WiktorPWR/Robot-Arm-2/Code/Rasberry-Pi-code/Readme.md

Here you will find a description of how the code works and what role the Raspberry Pi plays in the entire project.
