WiktorPWR/Robot-Arm-2/Code/STM32-code/Readme.md

Here you will find a description of how the code works and what function the STM32 itself performs in the entire project.
