WiktorPWR/Robot-Arm-2/images/communication_seuensce_diagram.png

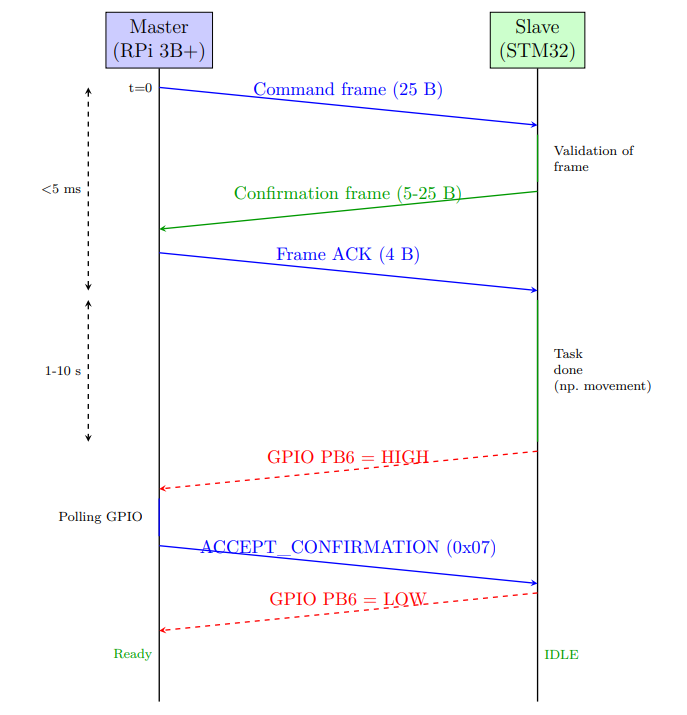
images/communication_seuensce_diagram.png
