WiktorPWR/Robot-Arm-2/images/communication_state_machine.png

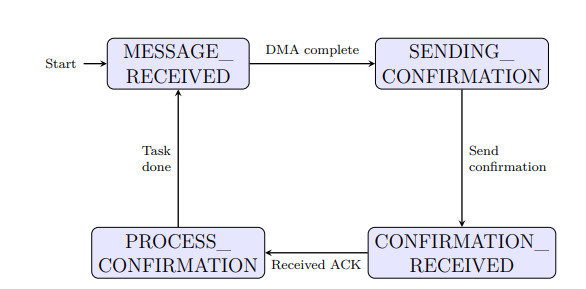
images/communication_state_machine.png
