WiktorPWR/Robot-Arm-2/images/Komunikacja_nkoder_magnetyczny.drawio.png

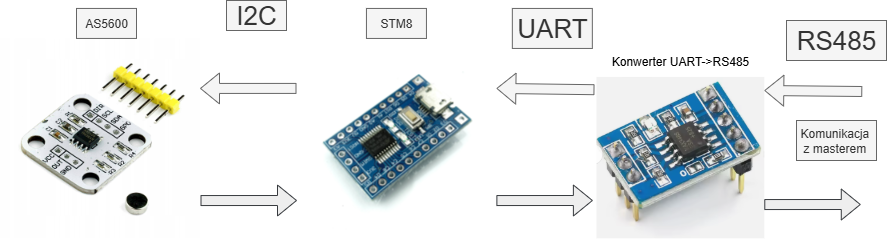
images/Komunikacja_nkoder_magnetyczny.drawio.png
