WiktorPWR/Robot-Arm-2/images/machine_state_rs485.png

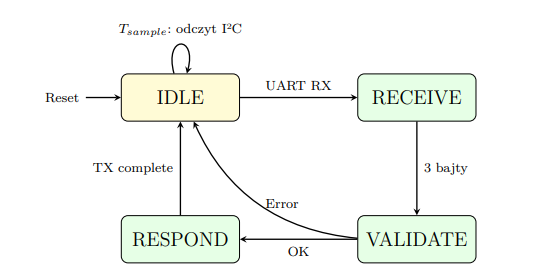
images/machine_state_rs485.png
