WiktorPWR/Robot-Arm-2/images/overengier_meme.jpg

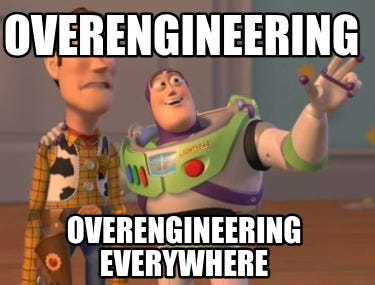
images/overengier_meme.jpg
