WiktorPWR/Robot-Arm-2/images/Oś_1_przekładania_zdjecie.jpg

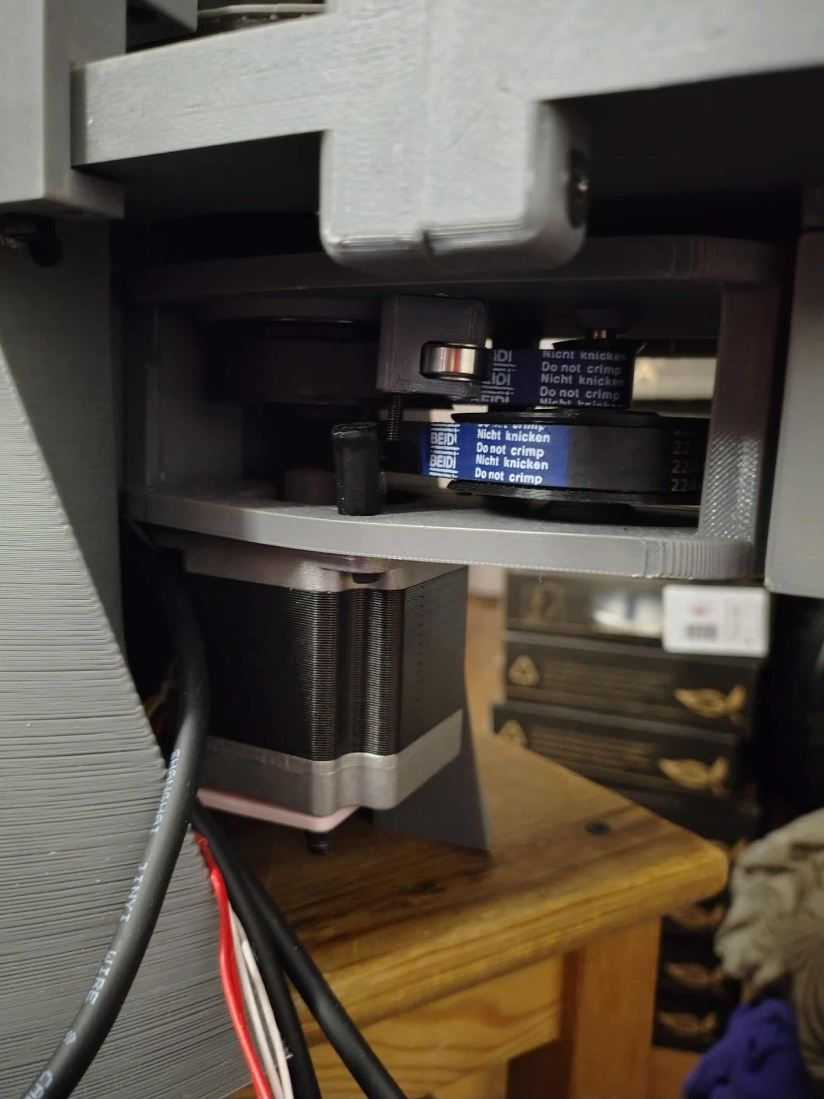
images/Oś_1_przekładania_zdjecie.jpg
