WiktorPWR/Robot-Arm-2/images/Oś_2_3_przekładania_zdjecie.jpg

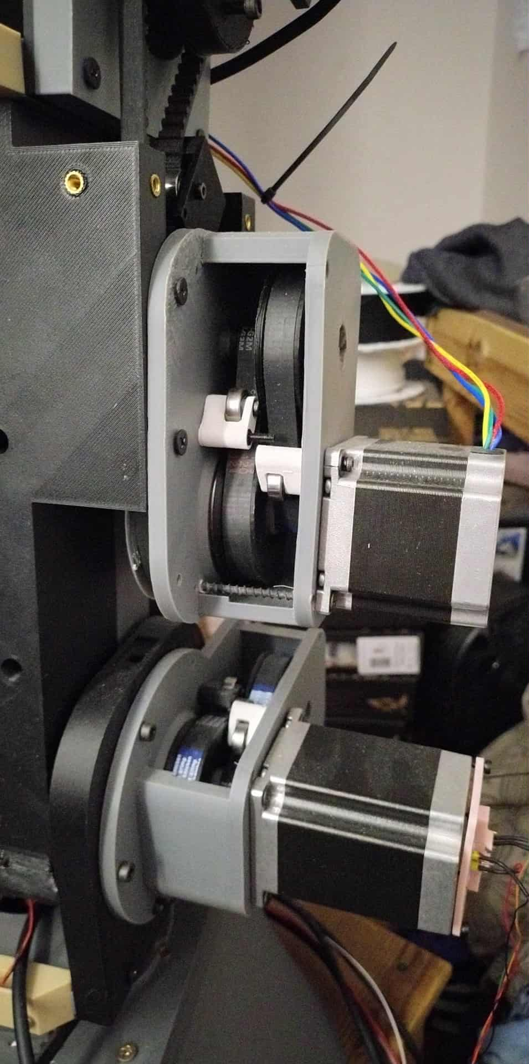
images/Oś_2_3_przekładania_zdjecie.jpg
