WiktorPWR/Robot-Arm-2/images/Oś_5_przekładania_zdjecie.jpg

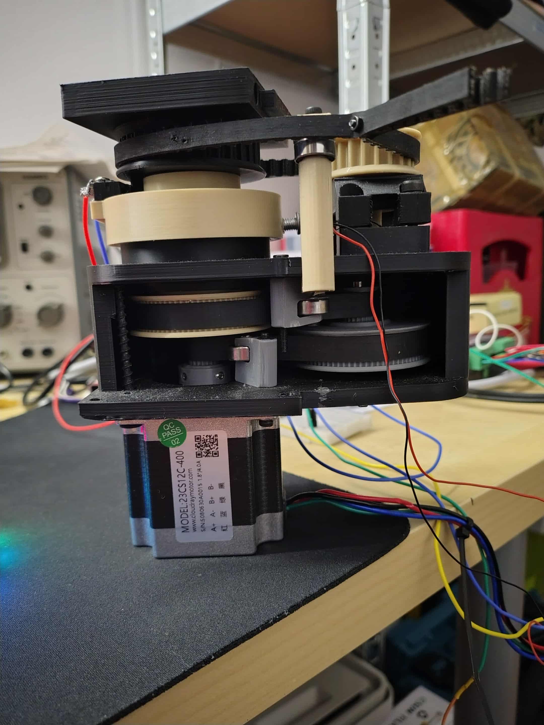
images/Oś_5_przekładania_zdjecie.jpg
