WiktorPWR/Robot-Arm-2/images/rs485_sequence_diagram.png

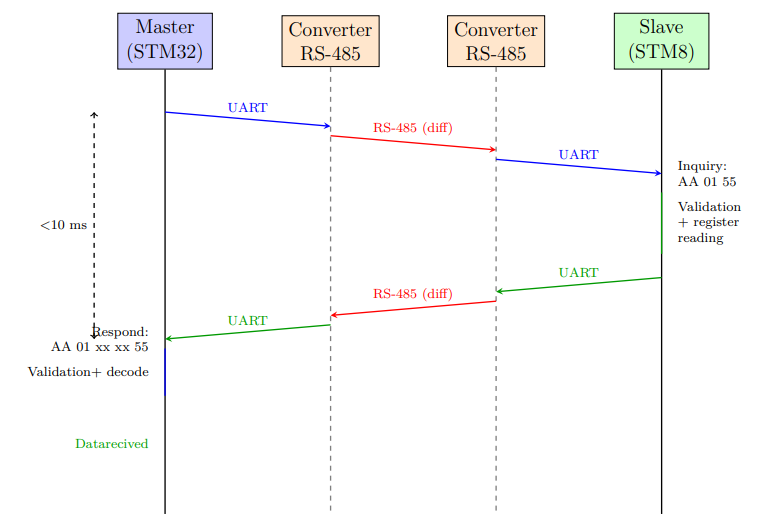
images/rs485_sequence_diagram.png
