WiktorPWR/Robot-Arm-2/images/system_architecture_1.png

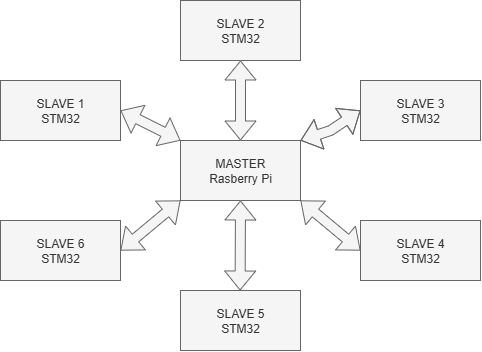
images/system_architecture_1.png
