WiktorPWR/Robot-Arm-2/images/system_architecture_2.png

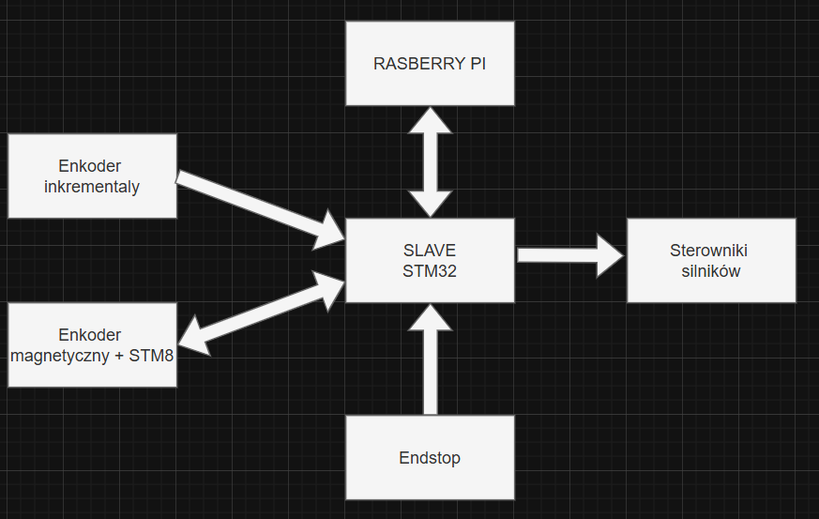
images/system_architecture_2.png
