WiktorPWR/Robot-Arm-2/Code/Rasberry-Pi-code/backend/robot/slave_master_communication/communication_test/spi_test_report_20260220_152733.txt

======================================================================
  TESTY PROTOKOLU SPI  |  Start: 2026-02-20 15:27:33
======================================================================

======================================================================
  KATEGORIA 1: Poprawny zapis (WRITE) do rejestrow
======================================================================

──────────────────────────────────────────────────────────────────────
TEST: 1.1  WRITE REG_HOMING = 1 (start homing)
      Kat.: 01-Write-Valid  |  WRITE reg=REG_HOMING fid=0x0001 data=1B
──────────────────────────────────────────────────────────────────────
    [OK  ] VALIDATION: OK_FRAME (0x00)  [oczekiwano: OK_FRAME]
    Slave COMMIT: START[OK]=0x55  COMMIT[OK]=0x9A  ERR=0x00(OK_FRAME)  END[OK]=0xAA
    Czekam na READY_SLAVE_FLAG (GPIO22 LOW)...
    WARN: Timeout GPIO22 – callback moze nie dzialac
  PASSED

──────────────────────────────────────────────────────────────────────
TEST: 1.2  WRITE REG_HOMING = 0 (stop homing)
      Kat.: 01-Write-Valid  |  WRITE reg=REG_HOMING fid=0x0002 data=1B
──────────────────────────────────────────────────────────────────────
    [OK  ] VALIDATION: OK_FRAME (0x00)  [oczekiwano: OK_FRAME]
    Slave COMMIT: START[OK]=0x55  COMMIT[OK]=0x9A  ERR=0x00(OK_FRAME)  END[OK]=0xAA
    Czekam na READY_SLAVE_FLAG (GPIO22 LOW)...
    WARN: Timeout GPIO22 – callback moze nie dzialac
  PASSED

──────────────────────────────────────────────────────────────────────
TEST: 1.3  WRITE REG_MOVE_ANGLE = 90
      Kat.: 01-Write-Valid  |  WRITE reg=REG_MOVE_ANGLE fid=0x0003 data=4B
──────────────────────────────────────────────────────────────────────
    [OK  ] VALIDATION: OK_FRAME (0x00)  [oczekiwano: OK_FRAME]
    Slave COMMIT: START[OK]=0x55  COMMIT[OK]=0x9A  ERR=0x00(OK_FRAME)  END[OK]=0xAA
    Czekam na READY_SLAVE_FLAG (GPIO22 LOW)...
    WARN: Timeout GPIO22 – callback moze nie dzialac
  PASSED

──────────────────────────────────────────────────────────────────────
TEST: 1.4  WRITE REG_MOVE_ANGLE = 0
      Kat.: 01-Write-Valid  |  WRITE reg=REG_MOVE_ANGLE fid=0x0004 data=4B
──────────────────────────────────────────────────────────────────────
    [OK  ] VALIDATION: OK_FRAME (0x00)  [oczekiwano: OK_FRAME]
    Slave COMMIT: START[OK]=0x55  COMMIT[OK]=0x9A  ERR=0x00(OK_FRAME)  END[OK]=0xAA
    Czekam na READY_SLAVE_FLAG (GPIO22 LOW)...
    WARN: Timeout GPIO22 – callback moze nie dzialac
  PASSED

──────────────────────────────────────────────────────────────────────
TEST: 1.5  WRITE REG_MOVE_ANGLE = 0xFFFFFFFF
      Kat.: 01-Write-Valid  |  WRITE reg=REG_MOVE_ANGLE fid=0x0005 data=4B
──────────────────────────────────────────────────────────────────────
    [OK  ] VALIDATION: OK_FRAME (0x00)  [oczekiwano: OK_FRAME]
    Slave COMMIT: START[OK]=0x55  COMMIT[OK]=0x9A  ERR=0x00(OK_FRAME)  END[OK]=0xAA
    Czekam na READY_SLAVE_FLAG (GPIO22 LOW)...
    WARN: Timeout GPIO22 – callback moze nie dzialac
  PASSED

──────────────────────────────────────────────────────────────────────
TEST: 1.6  WRITE REG_DIAG_CONTROL = 0x01
      Kat.: 01-Write-Valid  |  WRITE reg=REG_DIAG_CONTROL fid=0x0006 data=1B
──────────────────────────────────────────────────────────────────────
    [OK  ] VALIDATION: OK_FRAME (0x00)  [oczekiwano: OK_FRAME]
    Slave COMMIT: START[OK]=0x55  COMMIT[OK]=0x9A  ERR=0x00(OK_FRAME)  END[OK]=0xAA
    Czekam na READY_SLAVE_FLAG (GPIO22 LOW)...
    WARN: Timeout GPIO22 – callback moze nie dzialac
  PASSED

──────────────────────────────────────────────────────────────────────
TEST: 1.7  WRITE REG_EMERGENCY_STOP = 1 (aktywacja)
      Kat.: 01-Write-Valid  |  WRITE reg=REG_EMERGENCY_STOP fid=0x0007 data=1B
──────────────────────────────────────────────────────────────────────
    [OK  ] VALIDATION: OK_FRAME (0x00)  [oczekiwano: OK_FRAME]
    Slave COMMIT: START[OK]=0x55  COMMIT[OK]=0x9A  ERR=0x00(OK_FRAME)  END[OK]=0xAA
    Czekam na READY_SLAVE_FLAG (GPIO22 LOW)...
    WARN: Timeout GPIO22 – callback moze nie dzialac
  PASSED

──────────────────────────────────────────────────────────────────────
TEST: 1.8  WRITE REG_EMERGENCY_STOP = 0 (dezaktywacja)
      Kat.: 01-Write-Valid  |  WRITE reg=REG_EMERGENCY_STOP fid=0x0008 data=1B
──────────────────────────────────────────────────────────────────────
    [OK  ] VALIDATION: OK_FRAME (0x00)  [oczekiwano: OK_FRAME]
    Slave COMMIT: START[OK]=0x55  COMMIT[OK]=0x9A  ERR=0x00(OK_FRAME)  END[OK]=0xAA
    Czekam na READY_SLAVE_FLAG (GPIO22 LOW)...
    WARN: Timeout GPIO22 – callback moze nie dzialac
  PASSED

======================================================================
  KATEGORIA 2: Poprawny odczyt (READ) z rejestrów
======================================================================

──────────────────────────────────────────────────────────────────────
TEST: 2.1  READ REG_HOMING (1B)
      Kat.: 02-Read-Valid  |  READ reg=REG_HOMING fid=0x0009 size=1B
──────────────────────────────────────────────────────────────────────
    [OK  ] VALIDATION: OK_FRAME (0x00)  [oczekiwano: OK_FRAME]
    Dane od slave : ['0x00']
    CRC rx=0xC704DD7B  calc=0xC704DD7B  OK
  PASSED

    -> REG_HOMING = 0x00

──────────────────────────────────────────────────────────────────────
TEST: 2.2  READ REG_MOVE_ANGLE (4B)
      Kat.: 02-Read-Valid  |  READ reg=REG_MOVE_ANGLE fid=0x000A size=4B
──────────────────────────────────────────────────────────────────────
    [OK  ] VALIDATION: OK_FRAME (0x00)  [oczekiwano: OK_FRAME]
    Dane od slave : ['0xFF', '0xFF', '0xFF', '0xFF']
    CRC rx=0x00000000  calc=0x00000000  OK
  PASSED

    -> REG_MOVE_ANGLE = 4294967295

──────────────────────────────────────────────────────────────────────
TEST: 2.3  READ REG_DIAG_STATUS (4B, read-only)
      Kat.: 02-Read-Valid  |  READ reg=REG_DIAG_STATUS fid=0x000B size=4B
──────────────────────────────────────────────────────────────────────
    [OK  ] VALIDATION: OK_FRAME (0x00)  [oczekiwano: OK_FRAME]
    Dane od slave : ['0x00', '0x00', '0x00', '0x00']
    CRC rx=0xC704DD7B  calc=0xC704DD7B  OK
  PASSED

    -> REG_DIAG_STATUS = 0x00000000

──────────────────────────────────────────────────────────────────────
TEST: 2.4  READ REG_EMERGENCY_STOP (1B)
      Kat.: 02-Read-Valid  |  READ reg=REG_EMERGENCY_STOP fid=0x000C size=1B
──────────────────────────────────────────────────────────────────────
    [OK  ] VALIDATION: OK_FRAME (0x00)  [oczekiwano: OK_FRAME]
    Dane od slave : ['0x00']
    CRC rx=0xC704DD7B  calc=0xC704DD7B  OK
  PASSED

    -> REG_EMERGENCY_STOP = 0x00

──────────────────────────────────────────────────────────────────────
TEST: 2.5a WRITE REG_MOVE_ANGLE = 0x12345678
      Kat.: 02-Read-Valid  |  WRITE reg=REG_MOVE_ANGLE fid=0x000D data=4B
──────────────────────────────────────────────────────────────────────
    [OK  ] VALIDATION: OK_FRAME (0x00)  [oczekiwano: OK_FRAME]
    Slave COMMIT: START[OK]=0x55  COMMIT[OK]=0x9A  ERR=0x00(OK_FRAME)  END[OK]=0xAA
    Czekam na READY_SLAVE_FLAG (GPIO22 LOW)...
    WARN: Timeout GPIO22 – callback moze nie dzialac
  PASSED

──────────────────────────────────────────────────────────────────────
TEST: 2.5b READ REG_MOVE_ANGLE (round-trip)
      Kat.: 02-Read-Valid  |  READ reg=REG_MOVE_ANGLE fid=0x000E size=4B
──────────────────────────────────────────────────────────────────────
    [OK  ] VALIDATION: OK_FRAME (0x00)  [oczekiwano: OK_FRAME]
    Dane od slave : ['0x78', '0x78', '0x78', '0x78']
    CRC rx=0x9131D16A  calc=0x9131D16A  OK
  PASSED

    -> Round-trip [FAIL]: zapisano=0x12345678  odczytano=0x78787878

======================================================================
  KATEGORIA 3: Bledny START_BYTE w naglowku
======================================================================

──────────────────────────────────────────────────────────────────────
TEST: 3.x  WRITE z START_BYTE=0xAA
      Kat.: 03-Bad-StartByte  |  WRITE reg=REG_HOMING fid=0x000F data=1B
──────────────────────────────────────────────────────────────────────
    [OK  ] VALIDATION: WRONG_START_BYTE (0x01)  [oczekiwano: WRONG_START_BYTE]
    OK: Slave odrzucil naglowek: WRONG_START_BYTE
  PASSED

╔════════════════════════════════════════════════════════════════════╗
║                      FLOW KOMUNIKACJI                              ║
╚════════════════════════════════════════════════════════════════════╝

──────────────────────────────────────────────────────────────────────
  Krok 1: 1. SYN -> slave
──────────────────────────────────────────────────────────────────────
  MOSI (Master->Slave): ['0x97']
  MISO (Slave->Master): ['0x6A']

──────────────────────────────────────────────────────────────────────
  Krok 2: 2. Odbior SYN_ACK
──────────────────────────────────────────────────────────────────────
  MOSI (Master->Slave): ['0xFF']
  MISO (Slave->Master): ['0x98']

──────────────────────────────────────────────────────────────────────
  Krok 3: 3. ACK -> slave
──────────────────────────────────────────────────────────────────────
  MOSI (Master->Slave): ['0x99']
  MISO (Slave->Master): ['0x98']

──────────────────────────────────────────────────────────────────────
  Krok 4: 4. HEADER (14B) -> slave
──────────────────────────────────────────────────────────────────────
  MOSI (Master->Slave): ['0xAA', '0x01', '0x00', '0x0F', '0x02', '0x00', '0x00', '0x00', '0x01', '0xD0', '0x7B', '0x81', '0xD1', '0xAA']
  MISO (Slave->Master): ['0x98', '0x98', '0x98', '0x98', '0x98', '0x98', '0x98', '0x98', '0x98', '0x98', '0x98', '0x98', '0x98', '0x98']

──────────────────────────────────────────────────────────────────────
  Krok 5: 5. Odbior VALIDATION_CODE
──────────────────────────────────────────────────────────────────────
  MOSI (Master->Slave): ['0xFF']
  MISO (Slave->Master): ['0x01']

======================================================================

──────────────────────────────────────────────────────────────────────
TEST: 3.x  WRITE z START_BYTE=0x00
      Kat.: 03-Bad-StartByte  |  WRITE reg=REG_HOMING fid=0x0010 data=1B
──────────────────────────────────────────────────────────────────────
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
    OK: Slave odrzucil bledny data_size
  PASSED

======================================================================
  KATEGORIA 8: Duplikat frame_id (WRONG_FRAME_ID)
======================================================================

──────────────────────────────────────────────────────────────────────
TEST: 8.1  Pierwszy WRITE z frame_id
      Kat.: 08-DupFrameID  |  WRITE reg=REG_HOMING fid=0x0022 data=1B
──────────────────────────────────────────────────────────────────────
    [OK  ] VALIDATION: OK_FRAME (0x00)  [oczekiwano: OK_FRAME]
    Slave COMMIT: START[OK]=0x55  COMMIT[OK]=0x9A  ERR=0x00(OK_FRAME)  END[OK]=0xAA
    Czekam na READY_SLAVE_FLAG (GPIO22 LOW)...
    WARN: Timeout GPIO22 – callback moze nie dzialac
  PASSED

──────────────────────────────────────────────────────────────────────
TEST: 8.2  Ten sam frame_id – oczekuj WRONG_FRAME_ID
      Kat.: 08-DupFrameID  |  WRITE reg=REG_HOMING fid=0x0022 data=1B
──────────────────────────────────────────────────────────────────────
    [OK  ] VALIDATION: WRONG_FRAME_ID (0x02)  [oczekiwano: WRONG_FRAME_ID]
    OK: Slave odrzucil naglowek: WRONG_FRAME_ID
  PASSED

╔════════════════════════════════════════════════════════════════════╗
║                      FLOW KOMUNIKACJI                              ║
╚════════════════════════════════════════════════════════════════════╝

──────────────────────────────────────────────────────────────────────
  Krok 1: 1. SYN -> slave
──────────────────────────────────────────────────────────────────────
  MOSI (Master->Slave): ['0x97']
  MISO (Slave->Master): ['0xAA']

──────────────────────────────────────────────────────────────────────
  Krok 2: 2. Odbior SYN_ACK
──────────────────────────────────────────────────────────────────────
  MOSI (Master->Slave): ['0xFF']
  MISO (Slave->Master): ['0x98']

──────────────────────────────────────────────────────────────────────
  Krok 3: 3. ACK -> slave
──────────────────────────────────────────────────────────────────────
  MOSI (Master->Slave): ['0x99']
  MISO (Slave->Master): ['0x98']

──────────────────────────────────────────────────────────────────────
  Krok 4: 4. HEADER (14B) -> slave
──────────────────────────────────────────────────────────────────────
  MOSI (Master->Slave): ['0x55', '0x01', '0x00', '0x22', '0x02', '0x00', '0x00', '0x00', '0x01', '0x1D', '0xAD', '0xDD', '0xFA', '0xAA']
  MISO (Slave->Master): ['0x98', '0x98', '0x98', '0x98', '0x98', '0x98', '0x98', '0x98', '0x98', '0x98', '0x98', '0x98', '0x98', '0x98']

──────────────────────────────────────────────────────────────────────
  Krok 5: 5. Odbior VALIDATION_CODE
──────────────────────────────────────────────────────────────────────
  MOSI (Master->Slave): ['0xFF']
  MISO (Slave->Master): ['0x02']

======================================================================

──────────────────────────────────────────────────────────────────────
TEST: 8.3  Nowy frame_id – powinien przejsc
      Kat.: 08-DupFrameID  |  WRITE reg=REG_HOMING fid=0x0023 data=1B
──────────────────────────────────────────────────────────────────────
    [OK  ] VALIDATION: OK_FRAME (0x00)  [oczekiwano: OK_FRAME]
    Slave COMMIT: START[OK]=0x55  COMMIT[OK]=0x9A  ERR=0x00(OK_FRAME)  END[OK]=0xAA
    Czekam na READY_SLAVE_FLAG (GPIO22 LOW)...
    WARN: Timeout GPIO22 – callback moze nie dzialac
  PASSED

======================================================================
  KATEGORIA 9: Nieprawidlowa operacja (WRONG_OPERATION)
======================================================================

──────────────────────────────────────────────────────────────────────
TEST: 9.1  READ z write-only rejestru (REG_DIAG_CONTROL)
      Kat.: 09-BadOperation  |  READ reg=REG_DIAG_CONTROL fid=0x0024 size=1B
──────────────────────────────────────────────────────────────────────
    [OK  ] VALIDATION: WRONG_OPERATION (0x08)  [oczekiwano: WRONG_OPERATION]
    OK: Slave odrzucil naglowek: WRONG_OPERATION
  PASSED

╔════════════════════════════════════════════════════════════════════╗
║                      FLOW KOMUNIKACJI                              ║
╚════════════════════════════════════════════════════════════════════╝

──────────────────────────────────────────────────────────────────────
  Krok 1: 1. SYN -> slave
──────────────────────────────────────────────────────────────────────
  MOSI (Master->Slave): ['0x97']
  MISO (Slave->Master): ['0xAA']

──────────────────────────────────────────────────────────────────────
  Krok 2: 2. Odbior SYN_ACK
──────────────────────────────────────────────────────────────────────
  MOSI (Master->Slave): ['0xFF']
  MISO (Slave->Master): ['0x98']

──────────────────────────────────────────────────────────────────────
  Krok 3: 3. ACK -> slave
──────────────────────────────────────────────────────────────────────
  MOSI (Master->Slave): ['0x99']
  MISO (Slave->Master): ['0x98']

──────────────────────────────────────────────────────────────────────
  Krok 4: 4. HEADER (14B) -> slave
──────────────────────────────────────────────────────────────────────
  MOSI (Master->Slave): ['0x55', '0x01', '0x00', '0x24', '0x01', '0x00', '0x02', '0x00', '0x01', '0xF6', '0x8F', '0x4B', '0x7A', '0xAA']
  MISO (Slave->Master): ['0x98', '0x98', '0x98', '0x98', '0x98', '0x98', '0x98', '0x98', '0x98', '0x98', '0x98', '0x98', '0x98', '0x98']

──────────────────────────────────────────────────────────────────────
  Krok 5: 5. Odbior VALIDATION_CODE
──────────────────────────────────────────────────────────────────────
  MOSI (Master->Slave): ['0xFF']
  MISO (Slave->Master): ['0x08']

======================================================================

──────────────────────────────────────────────────────────────────────
TEST: 9.2  WRITE do read-only rejestru (REG_DIAG_STATUS)
      Kat.: 09-BadOperation  |  WRITE reg=REG_DIAG_STATUS fid=0x0025 data=4B
──────────────────────────────────────────────────────────────────────
    [OK  ] VALIDATION: WRONG_OPERATION (0x08)  [oczekiwano: WRONG_OPERATION]
    OK: Slave odrzucil naglowek: WRONG_OPERATION
  PASSED

╔════════════════════════════════════════════════════════════════════╗
║                      FLOW KOMUNIKACJI                              ║
╚════════════════════════════════════════════════════════════════════╝

──────────────────────────────────────────────────────────────────────
  Krok 1: 1. SYN -> slave
──────────────────────────────────────────────────────────────────────
  MOSI (Master->Slave): ['0x97']
  MISO (Slave->Master): ['0x08']

──────────────────────────────────────────────────────────────────────
  Krok 2: 2. Odbior SYN_ACK
──────────────────────────────────────────────────────────────────────
  MOSI (Master->Slave): ['0xFF']
  MISO (Slave->Master): ['0x98']

──────────────────────────────────────────────────────────────────────
  Krok 3: 3. ACK -> slave
──────────────────────────────────────────────────────────────────────
  MOSI (Master->Slave): ['0x99']
  MISO (Slave->Master): ['0x98']

──────────────────────────────────────────────────────────────────────
  Krok 4: 4. HEADER (14B) -> slave
──────────────────────────────────────────────────────────────────────
  MOSI (Master->Slave): ['0x55', '0x01', '0x00', '0x25', '0x02', '0x00', '0x03', '0x00', '0x04', '0x27', '0xBB', '0x51', '0x5B', '0xAA']
  MISO (Slave->Master): ['0x98', '0x98', '0x98', '0x98', '0x98', '0x98', '0x98', '0x98', '0x98', '0x98', '0x98', '0x98', '0x98', '0x98']

──────────────────────────────────────────────────────────────────────
  Krok 5: 5. Odbior VALIDATION_CODE
──────────────────────────────────────────────────────────────────────
  MOSI (Master->Slave): ['0xFF']
  MISO (Slave->Master): ['0x08']

======================================================================

──────────────────────────────────────────────────────────────────────
TEST: 9.3  operation_type=0x03
      Kat.: 09-BadOperation  |  operation_type=0x03
──────────────────────────────────────────────────────────────────────
    [OK  ] VALIDATION: WRONG_OPERATION (0x08)  [oczekiwano: WRONG_OPERATION]
    OK: Slave odrzucil nieprawidlowy operation_type
  PASSED

──────────────────────────────────────────────────────────────────────
TEST: 9.4  operation_type=0x00
      Kat.: 09-BadOperation  |  operation_type=0x00
──────────────────────────────────────────────────────────────────────
    [OK  ] VALIDATION: WRONG_OPERATION (0x08)  [oczekiwano: WRONG_OPERATION]
    OK: Slave odrzucil nieprawidlowy operation_type
  PASSED

──────────────────────────────────────────────────────────────────────
TEST: 9.5  operation_type=0xFF
      Kat.: 09-BadOperation  |  operation_type=0xFF
──────────────────────────────────────────────────────────────────────
    [OK  ] VALIDATION: WRONG_OPERATION (0x08)  [oczekiwano: WRONG_OPERATION]
    OK: Slave odrzucil nieprawidlowy operation_type
  PASSED

======================================================================
  KATEGORIA 10: Bledne CRC w naglowku (WRONG_CRC_VALUE)
======================================================================

──────────────────────────────────────────────────────────────────────
TEST: 10.1 WRITE z celowo blednym CRC naglowka
      Kat.: 10-Bad-HdrCRC  |  WRITE reg=REG_HOMING fid=0x0029 data=1B
──────────────────────────────────────────────────────────────────────
    [OK  ] VALIDATION: WRONG_CRC_VALUE (0x07)  [oczekiwano: WRONG_CRC_VALUE]
    OK: Slave odrzucil naglowek: WRONG_CRC_VALUE
  PASSED

╔════════════════════════════════════════════════════════════════════╗
║                      FLOW KOMUNIKACJI                              ║
╚════════════════════════════════════════════════════════════════════╝

──────────────────────────────────────────────────────────────────────
  Krok 1: 1. SYN -> slave
──────────────────────────────────────────────────────────────────────
  MOSI (Master->Slave): ['0x97']
  MISO (Slave->Master): ['0x08']

──────────────────────────────────────────────────────────────────────
  Krok 2: 2. Odbior SYN_ACK
──────────────────────────────────────────────────────────────────────
  MOSI (Master->Slave): ['0xFF']
  MISO (Slave->Master): ['0x98']

──────────────────────────────────────────────────────────────────────
  Krok 3: 3. ACK -> slave
──────────────────────────────────────────────────────────────────────
  MOSI (Master->Slave): ['0x99']
  MISO (Slave->Master): ['0x98']

──────────────────────────────────────────────────────────────────────
  Krok 4: 4. HEADER (14B) -> slave
──────────────────────────────────────────────────────────────────────
  MOSI (Master->Slave): ['0x55', '0x01', '0x00', '0x29', '0x02', '0x00', '0x00', '0x00', '0x01', '0x61', '0xC0', '0xA0', '0xC0', '0xAA']
  MISO (Slave->Master): ['0x98', '0x98', '0x98', '0x98', '0x98', '0x98', '0x98', '0x98', '0x98', '0x98', '0x98', '0x98', '0x98', '0x98']

──────────────────────────────────────────────────────────────────────
  Krok 5: 5. Odbior VALIDATION_CODE
──────────────────────────────────────────────────────────────────────
  MOSI (Master->Slave): ['0xFF']
  MISO (Slave->Master): ['0x07']

======================================================================

──────────────────────────────────────────────────────────────────────
TEST: 10.2 READ z celowo blednym CRC naglowka
      Kat.: 10-Bad-HdrCRC  |  READ reg=REG_HOMING fid=0x002A size=1B
──────────────────────────────────────────────────────────────────────
    [OK  ] VALIDATION: WRONG_CRC_VALUE (0x07)  [oczekiwano: WRONG_CRC_VALUE]
    OK: Slave odrzucil naglowek: WRONG_CRC_VALUE
  PASSED

╔════════════════════════════════════════════════════════════════════╗
║                      FLOW KOMUNIKACJI                              ║
╚════════════════════════════════════════════════════════════════════╝

──────────────────────────────────────────────────────────────────────
  Krok 1: 1. SYN -> slave
──────────────────────────────────────────────────────────────────────
  MOSI (Master->Slave): ['0x97']
  MISO (Slave->Master): ['0x07']

──────────────────────────────────────────────────────────────────────
  Krok 2: 2. Odbior SYN_ACK
──────────────────────────────────────────────────────────────────────
  MOSI (Master->Slave): ['0xFF']
  MISO (Slave->Master): ['0x98']

──────────────────────────────────────────────────────────────────────
  Krok 3: 3. ACK -> slave
──────────────────────────────────────────────────────────────────────
  MOSI (Master->Slave): ['0x99']
  MISO (Slave->Master): ['0x98']

──────────────────────────────────────────────────────────────────────
  Krok 4: 4. HEADER (14B) -> slave
──────────────────────────────────────────────────────────────────────
  MOSI (Master->Slave): ['0x55', '0x01', '0x00', '0x2A', '0x01', '0x00', '0x00', '0x00', '0x01', '0x5C', '0xDB', '0x7D', '0xAD', '0xAA']
  MISO (Slave->Master): ['0x98', '0x98', '0x98', '0x98', '0x98', '0x98', '0x98', '0x98', '0x98', '0x98', '0x98', '0x98', '0x98', '0x98']

──────────────────────────────────────────────────────────────────────
  Krok 5: 5. Odbior VALIDATION_CODE
──────────────────────────────────────────────────────────────────────
  MOSI (Master->Slave): ['0xFF']
  MISO (Slave->Master): ['0x07']

======================================================================

======================================================================
  KATEGORIA 11: Bledne CRC w danych – sciezka WRITE
======================================================================

──────────────────────────────────────────────────────────────────────
TEST: 11.1 WRITE REG_HOMING z blednym CRC danych
      Kat.: 11-Bad-DataCRC  |  WRITE reg=REG_HOMING fid=0x002B data=1B
──────────────────────────────────────────────────────────────────────
    [OK  ] VALIDATION: OK_FRAME (0x00)  [oczekiwano: OK_FRAME]
    Slave COMMIT: START[OK]=0x55  COMMIT[OK]=0x9A  ERR=0x07(WRONG_CRC_VALUE)  END[OK]=0xAA
    OK: Slave wykryl blad CRC danych: WRONG_CRC_VALUE
  PASSED

──────────────────────────────────────────────────────────────────────
TEST: 11.2 WRITE REG_MOVE_ANGLE z blednym CRC danych
      Kat.: 11-Bad-DataCRC  |  WRITE reg=REG_MOVE_ANGLE fid=0x002C data=4B
──────────────────────────────────────────────────────────────────────
    [OK  ] VALIDATION: OK_FRAME (0x00)  [oczekiwano: OK_FRAME]
    Slave COMMIT: START[OK]=0x55  COMMIT[OK]=0x9A  ERR=0x07(WRONG_CRC_VALUE)  END[OK]=0xAA
    OK: Slave wykryl blad CRC danych: WRONG_CRC_VALUE
  PASSED

======================================================================
  KATEGORIA 12: Bledny COMMIT od mastera – sciezka READ
======================================================================

──────────────────────────────────────────────────────────────────────
TEST: 12.1 READ REG_MOVE_ANGLE + bledny COMMIT mastera
      Kat.: 12-Bad-MasterCommit  |  READ reg=REG_MOVE_ANGLE fid=0x002D size=4B
──────────────────────────────────────────────────────────────────────
    [OK  ] VALIDATION: OK_FRAME (0x00)  [oczekiwano: OK_FRAME]
    Dane od slave : ['0x78', '0x78', '0x78', '0x78']
    CRC rx=0x9131D16A  calc=0x9131D16A  OK
    WARN: Wysylam celowo bledny COMMIT (WRONG_CRC_VALUE)
  PASSED

──────────────────────────────────────────────────────────────────────
TEST: 12.2 READ REG_HOMING + bledny COMMIT mastera
      Kat.: 12-Bad-MasterCommit  |  READ reg=REG_HOMING fid=0x002E size=1B
──────────────────────────────────────────────────────────────────────
    [OK  ] VALIDATION: OK_FRAME (0x00)  [oczekiwano: OK_FRAME]
    Dane od slave : ['0x00']
    CRC rx=0xC704DD7B  calc=0xC704DD7B  OK
    WARN: Wysylam celowo bledny COMMIT (WRONG_CRC_VALUE)
  PASSED

======================================================================
  KATEGORIA 13: Testy timeoutu STM32
======================================================================

──────────────────────────────────────────────────────────────────────
TEST: 13.x Timeout po kroku: 'syn'
      Kat.: 13-Timeout  |  abort_after='syn'  delay=2.5s
──────────────────────────────────────────────────────────────────────
    Czekam 2.5s (symulacja timeoutu po SYN)...
    [RESET SPI] Czyszczenie magistrali...
    [RESET SPI] Gotowy.

    OK: STM32 zresetowal sie i odpowiada na SYN
  PASSED

╔════════════════════════════════════════════════════════════════════╗
║                      FLOW KOMUNIKACJI                              ║
╚════════════════════════════════════════════════════════════════════╝

──────────────────────────────────────────────────────────────────────
  Krok 1: 1. SYN
──────────────────────────────────────────────────────────────────────
  MOSI (Master->Slave): ['0x97']
  MISO (Slave->Master): ['0x7B']

──────────────────────────────────────────────────────────────────────
  Krok 2: SYN (po timeout)
──────────────────────────────────────────────────────────────────────
  MOSI (Master->Slave): ['0x97']
  MISO (Slave->Master): ['0x98']

──────────────────────────────────────────────────────────────────────
  Krok 3: SYN_ACK (po timeout)
──────────────────────────────────────────────────────────────────────
  MOSI (Master->Slave): ['0xFF']
  MISO (Slave->Master): ['0x98']

======================================================================

──────────────────────────────────────────────────────────────────────
TEST: 13.x Timeout po kroku: 'ack'
      Kat.: 13-Timeout  |  abort_after='ack'  delay=2.5s
──────────────────────────────────────────────────────────────────────
    Czekam 2.5s (symulacja timeoutu po ACK)...
    [RESET SPI] Czyszczenie magistrali...
    [RESET SPI] Gotowy.

    OK: STM32 zresetowal sie i odpowiada na SYN
  PASSED

╔════════════════════════════════════════════════════════════════════╗
║                      FLOW KOMUNIKACJI                              ║
╚════════════════════════════════════════════════════════════════════╝

──────────────────────────────────────────────────────────────────────
  Krok 1: 1. SYN
──────────────────────────────────────────────────────────────────────
  MOSI (Master->Slave): ['0x97']
  MISO (Slave->Master): ['0x98']

──────────────────────────────────────────────────────────────────────
  Krok 2: 2. SYN_ACK
──────────────────────────────────────────────────────────────────────
  MOSI (Master->Slave): ['0xFF']
  MISO (Slave->Master): ['0x98']

──────────────────────────────────────────────────────────────────────
  Krok 3: 3. ACK
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
TEST: 15.4 READ  REG_EMERGENCY_STOP
      Kat.: 15-Stress  |  READ reg=REG_EMERGENCY_STOP fid=0x0054 size=1B
──────────────────────────────────────────────────────────────────────
    [OK  ] VALIDATION: OK_FRAME (0x00)  [oczekiwano: OK_FRAME]
  PASSED

  Koniec testow: 2026-02-20 15:29:15

======================================================================
  PODSUMOWANIE TESTOW
======================================================================
  Lacznie testow : 91
  Udanych        : 87
  Nieudanych     : 4
  Wskaznik sukc. : 95.6%

----------------------------------------------------------------------
  Kategoria                               Pass  Total       %
----------------------------------------------------------------------
  [OK ] 01-Write-Valid                          8      8  100.0%
  [OK ] 02-Read-Valid                           6      6  100.0%
  [OK ] 03-Bad-StartByte                        4      4  100.0%
  [OK ] 04-Bad-SlaveID                          3      3  100.0%
  [OK ] 05-Bad-EndByte                          3      3  100.0%
  [OK ] 06-Bad-Register                         4      4  100.0%
  [OK ] 07-Bad-DataSize                         5      5  100.0%
  [OK ] 08-DupFrameID                           3      3  100.0%
  [OK ] 09-BadOperation                         5      5  100.0%
  [OK ] 10-Bad-HdrCRC                           2      2  100.0%
  [OK ] 11-Bad-DataCRC                          2      2  100.0%
  [OK ] 12-Bad-MasterCommit                     2      2  100.0%
  [OK ] 13-Timeout                              2      2  100.0%
  [!!!] 14-ReadyFlag                            4      8   50.0%
  [OK ] 15-Stress                              34     34  100.0%
======================================================================
  UWAGA: 4 testow wymaga uwagi
======================================================================
