WiktorPWR/Robot-Arm-2/Code/STM32-code/MASTER_SLAVE_SPI/MASTER_SLAVE_SPI.ioc

Mcu.UserName=STM32F103C8Tx
PA0-WKUP.GPIO_Label=PULL_PWM
PA0-WKUP.Signal=S_TIM2_CH1_ETR
PB3.Signal=SPI1_SCK
PB4.Signal=SPI1_MISO
PB5.Signal=SPI1_MOSI
PB6.GPIO_Label=READY_SLAVE_FLAG
PB6.Signal=GPIO_Output
PB7.Signal=GPXTI7
PD0-OSC_IN.Signal=RCC_OSC_IN
PD1-OSC_OUT.Signal=RCC_OSC_OUT
