WiktorPWR/Robot-Arm-2/Code/STM32-code/MASTER_SLAVE_SPI/Core/Inc/main.h

#define PULL_PWM_Pin GPIO_PIN_0
#define PULL_PWM_GPIO_Port GPIOA
#define READY_SLAVE_FLAG_Pin GPIO_PIN_6
#define READY_SLAVE_FLAG_GPIO_Port GPIOB
