WiktorPWR/Robot-Arm-2/Code/STM32-code/MASTER_SLAVE_SPI/Core/Src/motor/motor_functions.c

/*
 * motor_functions.c
 *
 *  Created on: Sep 14, 2025
 *      Author: ostro
 */
#include "main.h"
#include "endstop.h"
#include "motor/motor_data.h"
#include "motor/motor_functions.h"
#include "motor/S_curve_mathematic.h"

uint16_t MINIMAL_SPEED =  20;
uint16_t MAXIMAL_SPEED = 100;
uint16_t MAX_ACCELERATION = 10;
uint16_t MAX_JERK = 10;

enum Rotation_Direction rotation_direction;
enum Motor_State motor_state;
enum Homming_State homming_state = NOT_HOMMED;
enum IS_PWM_ACTIVE pwm_state;



extern TIM_HandleTypeDef htim2;

volatile uint16_t actual_position = 0;
volatile uint8_t endstop_state;



extern UART_HandleTypeDef huart2;
extern char debug_buffer[100];


/**
 * @brief  Enables the motor driver (sets ENABLE pin high).
 * @note   Sets the motor state to MOTOR_ENABLE.
 */
void motor_enable(){
	HAL_GPIO_WritePin(ENABLE_GPIO_Port, ENABLE_Pin, GPIO_PIN_RESET);
	motor_state = MOTOR_ENABLE;
}

/**
 * @brief  Disables the motor driver (sets ENABLE pin low).
 * @note   Sets the motor state to MOTOR_DISABLE.
 */
void motor_disable(){
	HAL_GPIO_WritePin(ENABLE_GPIO_Port, ENABLE_Pin, GPIO_PIN_SET);
	motor_state = MOTOR_DISABLE;
}


/**
 * @brief  Sets rotation direction to LEFT.
 */
void motor_rotate_left(){
	HAL_GPIO_WritePin(DIR_GPIO_Port, DIR_Pin, GPIO_PIN_SET);
	rotation_direction = LEFT;
}

/**
 * @brief  Sets rotation direction to RIGHT.
 */
void motor_rotate_right(){
	HAL_GPIO_WritePin(DIR_GPIO_Port, DIR_Pin, GPIO_PIN_RESET);
	rotation_direction = RIGHT;
}


/**
 * @brief  Generates a single manual step pulse on the PULL_MANUAL pin.
 * @note   Useful for manual fine-positioning or debugging.
 */
void motor_step_manual(){

	HAL_GPIO_WritePin(PULL_MANUAL_GPIO_Port, PULL_MANUAL_Pin, GPIO_PIN_SET);
	HAL_Delay(100);//10 ms
	HAL_GPIO_WritePin(PULL_MANUAL_GPIO_Port, PULL_MANUAL_Pin, GPIO_PIN_RESET);
	HAL_Delay(100);//10 ms
}

/**
 * @brief  Stops PWM output for motor motion (disables channel 1).
 */
void motor_stop(){
	HAL_TIM_PWM_Stop(&htim2, TIM_CHANNEL_1);
}


/**
 * @brief  Ensures TIM2 Channel 1 PWM output is active.
 *         Attempts to enable timer and channel if they are off.
 * @retval PWM_ACTIVE if PWM is confirmed running.
 * @retval SETUP_NOT_ACTIVE if PWM mode not configured.
 * @retval CANAL_NOT_ACTIVE or TIMER_NOT_ACTIVE if cannot be activated.
 */
static uint8_t is_pwm_active_ch2(void) {
    // --- 1. Timer enabled? ---
    if ((htim2.Instance->CR1 & TIM_CR1_CEN) == 0) {
        // Spróbuj włączyć timer
        htim2.Instance->CR1 |= TIM_CR1_CEN;

        // Krótka synchronizacja
        __DSB();
        __NOP();

        // Ponowne sprawdzenie
        if ((htim2.Instance->CR1 & TIM_CR1_CEN) == 0)
            return TIMER_NOT_ACTIVE;
    }

    // --- 2. Channel 1 enabled? ---
    if ((htim2.Instance->CCER & TIM_CCER_CC1E) == 0) {
        // Spróbuj włączyć wyjście kanału
        htim2.Instance->CCER |= TIM_CCER_CC1E;

        __DSB();
        __NOP();

        // Ponowne sprawdzenie
        if ((htim2.Instance->CCER & TIM_CCER_CC1E) == 0)
            return CANAL_NOT_ACTIVE;
    }

    // --- 3. PWM mode ustawiony dla kanału 1? ---
    uint32_t oc1m = htim2.Instance->CCMR1 & 0x7;  // bity 0-2 dla OC1M
    if (oc1m < 6)  // 6 = PWM mode 1, 7 = PWM mode 2
        return SETUP_NOT_ACTIVE;

    return PWM_ACTIVE;
}




/**
 * @brief  Configures the PWM timer to generate step pulses at a frequency
 *         corresponding to the desired motor speed (steps per second).
 *
 * @param  speed_steps_per_s  Desired pulse frequency in steps per second.
 *
 * @note
 * - If the speed is set to zero, PWM is stopped immediately.
 * - ARR and PSC are recalculated dynamically to achieve the target frequency.
 * - 50% duty cycle ensures clean step pulses for the stepper driver.
 */
void set_speed(uint16_t speed_steps_per_s)
{
//    // --- 0. Debug info ---
//    sprintf(debug_buffer, "\r\n[set_speed] Called with speed=%u steps/s\r\n", speed_steps_per_s);
//    HAL_UART_Transmit(&huart2, (uint8_t*)debug_buffer, strlen(debug_buffer), HAL_MAX_DELAY);

    // --- 1. Handle case when motor should stop ---
    if (speed_steps_per_s == 0)
    {
        HAL_TIM_PWM_Stop(&htim2, TIM_CHANNEL_1);
        sprintf(debug_buffer, "[set_speed] Speed = 0 -> PWM stopped\r\n");
        HAL_UART_Transmit(&huart2, (uint8_t*)debug_buffer, strlen(debug_buffer), HAL_MAX_DELAY);
        return;
    }

    // --- 2. Calculate initial ARR value (assuming prescaler = 0) ---
    uint32_t arr_value = (CLOCK_VALUE / speed_steps_per_s) - 1;
//    sprintf(debug_buffer, "[set_speed] Initial ARR (PSC=0) = %lu\r\n", arr_value);
//    HAL_UART_Transmit(&huart2, (uint8_t*)debug_buffer, strlen(debug_buffer), HAL_MAX_DELAY);

    // --- 3. Adjust prescaler dynamically if ARR exceeds 16-bit limit ---
    uint16_t prescaler = 0;
    while (arr_value > 0xFFFF)
    {
        prescaler++;
        arr_value = (CLOCK_VALUE / ((prescaler + 1) * speed_steps_per_s)) - 1;
    }
//    sprintf(debug_buffer, "[set_speed] Adjusted ARR=%lu, PSC=%u\r\n", arr_value, prescaler);
//    HAL_UART_Transmit(&huart2, (uint8_t*)debug_buffer, strlen(debug_buffer), HAL_MAX_DELAY);

    // --- 4. Apply calculated values to timer registers ---
    htim2.Instance->PSC  = prescaler;
    htim2.Instance->ARR  = (uint16_t)arr_value;
    htim2.Instance->CCR1 = (uint16_t)(0.5f * arr_value);

//    sprintf(debug_buffer, "[set_speed] Timer configured -> PSC=%lu, ARR=%lu, CCR1=%lu\r\n",
//            (uint32_t)htim2.Instance->PSC,
//            (uint32_t)htim2.Instance->ARR,
//            (uint32_t)htim2.Instance->CCR1);
//
//    HAL_UART_Transmit(&huart2, (uint8_t*)debug_buffer, strlen(debug_buffer), HAL_MAX_DELAY);

    // --- 5. Check if PWM channel is active ---
    uint8_t pwm_status = is_pwm_active_ch2();
//    sprintf(debug_buffer, "[set_speed] PWM status = %d\r\n", pwm_status);
//    HAL_UART_Transmit(&huart2, (uint8_t*)debug_buffer, strlen(debug_buffer), HAL_MAX_DELAY);

    if (pwm_status == 5)
    {
    	HAL_StatusTypeDef pwm_status_hal = HAL_TIM_PWM_Start(&htim2, TIM_CHANNEL_1);

//    	sprintf(debug_buffer, "[set_speed] HAL_TIM_PWM_Start() returned: %d\r\n", pwm_status_hal);
//    	HAL_UART_Transmit(&huart2, (uint8_t*)debug_buffer, strlen(debug_buffer), HAL_MAX_DELAY);
//
//    	switch (pwm_status_hal)
//    	{
//    	    case HAL_OK:
//    	        sprintf(debug_buffer, "[set_speed] PWM start -> OK\r\n");
//    	        break;
//    	    case HAL_ERROR:
//    	        sprintf(debug_buffer, "[set_speed] PWM start -> ERROR\r\n");
//    	        break;
//    	    case HAL_BUSY:
//    	        sprintf(debug_buffer, "[set_speed] PWM start -> BUSY\r\n");
//    	        break;
//    	    case HAL_TIMEOUT:
//    	        sprintf(debug_buffer, "[set_speed] PWM start -> TIMEOUT\r\n");
//    	        break;
//    	    default:
//    	        sprintf(debug_buffer, "[set_speed] PWM start -> UNKNOWN\r\n");
//    	        break;
//    	}
//
//    	HAL_UART_Transmit(&huart2, (uint8_t*)debug_buffer, strlen(debug_buffer), HAL_MAX_DELAY);

    }
    else
    {
        sprintf(debug_buffer, "[ERROR] PWM inactive (status=%d) -> Not starting\r\n", pwm_status);
        HAL_UART_Transmit(&huart2, (uint8_t*)debug_buffer, strlen(debug_buffer), HAL_MAX_DELAY);
    }

    // --- 6. Final debug ---
    sprintf(debug_buffer, "[set_speed] Complete. Output freq ≈ %u Hz\r\n", speed_steps_per_s);
    HAL_UART_Transmit(&huart2, (uint8_t*)debug_buffer, strlen(debug_buffer), HAL_MAX_DELAY);
}




/**
 * @brief  Updates minimal and maximal movement speed parameters.
 * @param  min_speed: Minimal speed value.
 * @param  max_speed: Maximal speed value.
 */
void change_movement_parameters(uint16_t min_speed, uint16_t max_speed, uint16_t max_acceleraiotn, uint16_t max_jerk ){
	MINIMAL_SPEED = min_speed;
	MAXIMAL_SPEED = max_speed;
	MAX_ACCELERATION = max_acceleraiotn;
	MAX_JERK = max_jerk;
}


/**
 * @brief  Performs homing procedure until endstop is triggered.
 * @retval HOMMED if successful.
 * @note   Runs motor at MINIMAL_SPEED until endstop_state == 1.
 */
uint8_t homming(void) {
    uint8_t prev_state = 1;
    uint8_t curr_state = 1;
    //uint32_t debounce_time = 0;

    motor_rotate_left();
    motor_enable();
    set_speed(MINIMAL_SPEED);

    sprintf(debug_buffer, "\r\n[HOME] Start homming\r\n");
    HAL_UART_Transmit(&huart2, (uint8_t*)debug_buffer, strlen(debug_buffer), HAL_MAX_DELAY);

    while (1) {
        curr_state = HAL_GPIO_ReadPin(ENDSTOP_GPIO_Port, ENDSTOP_Pin);

        // wykrycie zbocza opadającego
        if (prev_state == 0 && curr_state == 1) {
            // debouncing: poczekaj 10 ms i sprawdź ponownie
            HAL_Delay(10);
            if (HAL_GPIO_ReadPin(ENDSTOP_GPIO_Port, ENDSTOP_Pin) == 1) {
                sprintf(debug_buffer, "[HOME] Falling edge detected!\r\n");
                HAL_UART_Transmit(&huart2, (uint8_t*)debug_buffer, strlen(debug_buffer), HAL_MAX_DELAY);
                break;
            }
        }

        prev_state = curr_state;
    }

    motor_stop();
    sprintf(debug_buffer, "\r\n[HOME] Homing done ;)\r\n");
    HAL_UART_Transmit(&huart2, (uint8_t*)debug_buffer, strlen(debug_buffer), HAL_MAX_DELAY);

    homming_state = HOMMED;
    return HOMMED;
}


/**
 * @brief  Generates S-curve motion trajectory based on target position.
 * @param  target_position: Desired motor target position (degrees or steps).
 * @note   Configures motion parameters and fills trajectory buffer.
 */
void calculating_speed_profile(float target_position){
	config.max_velocity = MAXIMAL_SPEED;
	config.max_acceleration = MAX_ACCELERATION;
	config.max_jerk = MAX_JERK;
	config.interpolation_points = 100;

	// Configure motor (example: 3:1 gear ratio, 16 microsteps, 200 steps/rev)
	set_motor_config(GEAR_RATIO, MICROSTEPPING, STEPS_PER_REVOLUTION);

	generate_scurve_trajectory(target_position);

}


/**
 * @brief  Moves the motor by a specified angular distance using S-curve profile.
 * @param  angle: Target position (in degrees or equivalent units).
 * @retval HOMMED, NOT_HOMMED, or PWM state error codes.
 * @note   Executes velocity profile and fine-positioning correction.
 */
uint8_t move_via_angle(float angle)
{
	//WE HAVE GOT LITTLE ENDIAN HERE !!!!!!!!!!!!!!!!!!!!!

    // Check if homing was done
    if (homming_state != HOMMED) {
        sprintf(debug_buffer, "[ERROR] Homing not done!\r\n");
        HAL_UART_Transmit(&huart2, (uint8_t*)debug_buffer, strlen(debug_buffer), HAL_MAX_DELAY);
        return NOT_HOMMED;
    }

    HAL_TIMEx_PWMN_Start(&htim2, TIM_CHANNEL_1);


    // Determine rotation direction
    if (angle > actual_position)
        rotation_direction = LEFT;
    else
        rotation_direction = RIGHT;


    // Enable motor if needed
    if (motor_state == MOTOR_DISABLE) {

        motor_enable();
    }

    // Generate motion profile
    uint32_t t0 = HAL_GetTick();
    calculating_speed_profile(angle);
    uint32_t t1 = HAL_GetTick();


    uint32_t start_time = HAL_GetTick();
    uint32_t current_time = 0;
    uint8_t actual_value = 0;

    for (uint16_t i = 0; i < buffer_count; i++) {
        current_time = HAL_GetTick();
        while (trajectory_buffer[i].time_ms >= (current_time - start_time)) {
            if (actual_value == 0) {
                set_speed(trajectory_buffer[i].velocity_raw);
                actual_value = 1;
            }
            current_time = HAL_GetTick(); // odświeżenie czasu wewnątrz pętli!
        }
        actual_value = 0;
    }


    // Fine positioning phase (creep move)
    while (actual_position < angle + PERMITTED_POSITION_DEVIATION_VALUE &&
           actual_position > angle - PERMITTED_POSITION_DEVIATION_VALUE) {
        motor_step_manual();
    }


    // Overshoot slightly for backlash compensation
    for (uint8_t i = 0; i < ADDITIONAL_STEP; i++) {
        motor_step_manual();
    }


    return MOVEMENT_DONE;
}
