WiktorPWR/Robot-Arm-2/Code/STM32-code/MASTER_SLAVE_SPI/Core/Inc/motor/motor_data.h

enum Rotation_Direction{
	LEFT,
	RIGHT
};

enum Motor_State{
	MOTOR_ENABLE,
	MOTOR_DISABLE,
	MOVEMENT_DONE
};



enum Homming_State{
	NOT_HOMMED = 10,
	HOMMED = 11
};


enum IS_PWM_ACTIVE{
	TIMER_NOT_ACTIVE = 2,
	CANAL_NOT_ACTIVE = 3,
	SETUP_NOT_ACTIVE = 4,
	PWM_ACTIVE = 5
};



//Values for calculation PWM freq
#define ARR_VALUE 65535
#define CLOCK_VALUE 8000000// 8 000 000
#define DUTY_CYCLE 0.50
//Movement values
#define PERMITTED_POSITION_DEVIATION_VALUE 1
#define ADDITIONAL_STEP 5
//Hardware setup
#define STEPS_PER_REVOLUTION 200
#define MICROSTEPPING 16
#define GEAR_RATIO 17
