WiktorPWR/Robot-Arm-2/Code/STM32-code/MASTER_SLAVE_SPI/Core/Inc/motor/motor_functions.h

/*
 * motor_functions.h
 *
 *  Created on: Sep 14, 2025
 *      Author: ostro
 */

#ifndef INC_MOTOR_FUNCTIONS_H_
#define INC_MOTOR_FUNCTIONS_H_



uint8_t homming();

void motor_enable();

void motor_disable();

void motor_rotate_left();

void motor_rotate_right();

void motor_step_manual();

void set_speed(uint16_t speed);

uint8_t move_via_angle(float angle);


#endif /* INC_MOTOR_FUNCTIONS_H_ */
