WiktorPWR/Robot-Arm-2/Code/STM32-code/MASTER_SLAVE_SPI/Core/Inc/endstop.h

/*
 * endstop.h
 *
 *  Created on: Sep 26, 2025
 *      Author: ostro
 */

#ifndef INC_ENDSTOP_H_
#define INC_ENDSTOP_H_

#include <stdint.h>

extern volatile uint8_t endstop_state;

#endif /* INC_ENDSTOP_H_ */
