WiktorPWR/Robot-Arm-2/(commit log)

2025-10-23 Add readme for stm32
2025-10-23 Add initial README description for Raspberry Pi code
    Added a description of the code and Raspberry Pi's role.
2025-10-24 Adding a function that checks the coeectness of frame syntax elements.
2025-11-03 First frame gooes goooood
2025-11-12 Finnaly proper PWM aplication
2026-01-11 Revise README for 6-DOF Robotic Arm Project
    Updated project title and expanded project overview with detailed sections on mechanical construction, system architecture, communication protocols, and future development plans.
2026-01-14 Add SPI functions and cascade controller, ignore IDE files
