WiktorPWR/Robot-Arm-2/(notices)

Notices in the files:
Code/STM32-code/MASTER_SLAVE_SPI/Core/Inc/main.h:
Copyright (c) 2025 STMicroelectronics.
All rights reserved.
This software is licensed under terms that can be found in the LICENSE file
